SimonHubs/RoboFinch/Robofinch_assemblage_manual_dutch.pdf

Vrije Universiteit Amsterdam

# Robofinch

assembling manual

### Rogier Elsinga

6-6-2019

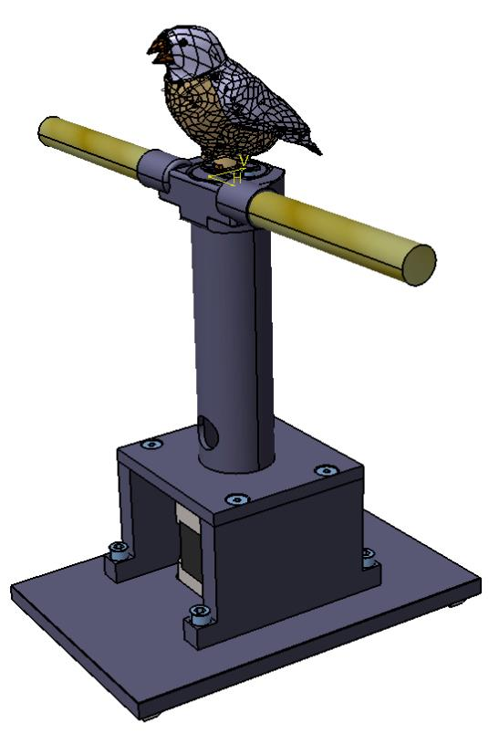
[picture p1: figure]

# Robofinch assemblage manual

## 1 Contents

Dit document beschrijft de assemblage van de robofinch zoals deze gemaakt is bij de afdeling FMIB in juni 2019. Het uitgangspunt is het afleveren van 8 robotvinken.

De hoofdfile die gebruikt is voor Catia V5R20 is:

Robofinch_assembly_w_bord_rotation17042019

In de locatie:

Z:\01-Tekeningenbestand NIEUW\2971100_dierenecologie\2971101 416101 robotvink\CAD\assembly\iteration_04172019

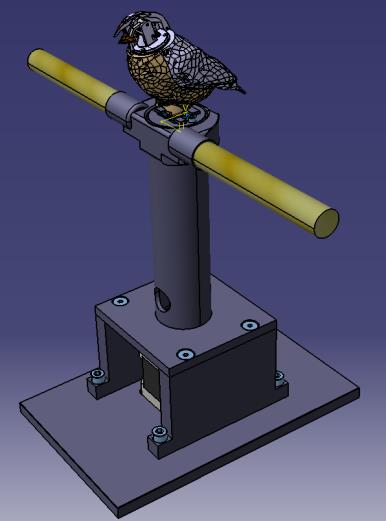
[picture p2: figure]

## 2 Het onder lichaam van de vogel

Part name: | lower_body_for_closing_chest09012019
Locatie: | Z:\01-Tekeningenbestand NIEUW\2971100_dierenecologie\2971101 416101
robotvink\CAD\assembly\iteration_12072018\lower_body_for_closing_chest_09012019.CATPart

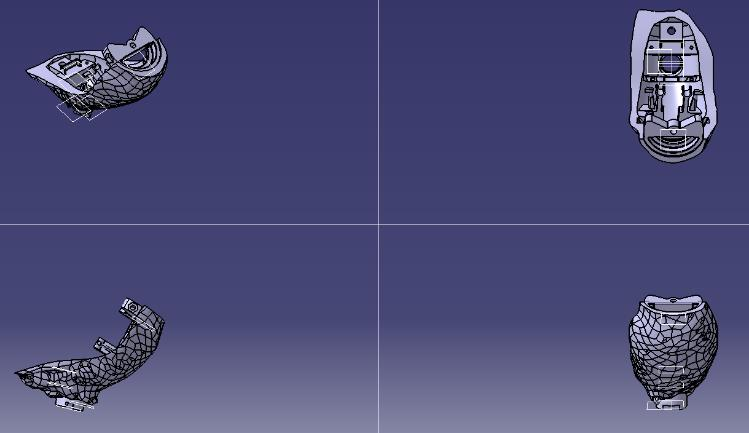
[picture p3: figure]

Printer: | Formlabs Form2
Materiaal: | Grey Pro
File naam: | batch1_lowerbody_8X
Locatie: | Z:\01-Tekeningenbestand NIEUW\2971100_dierenecologie\2971101 416101
robotvink\CAD\assembly\iteration_04172019\stl_voor_productie

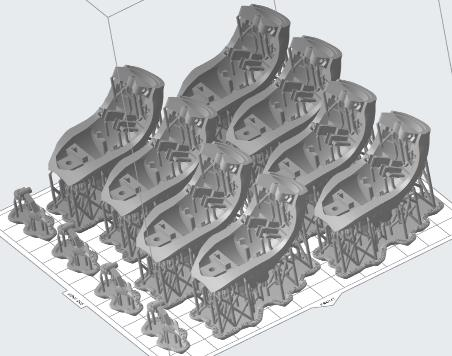
[picture p4: figure]

2.1.1 Afwerken geprint model:

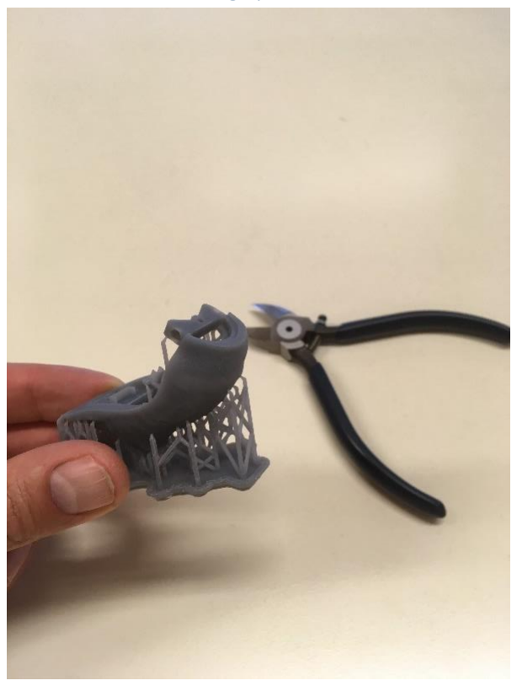
[picture p5: figure]

Na het spoelen en uiharden met de Formlabs wash en Cure alle support materiaal verwijderen en het product dusdanig netje afwerken.

2.1.2 Verlijmen van moer M1,6mm:

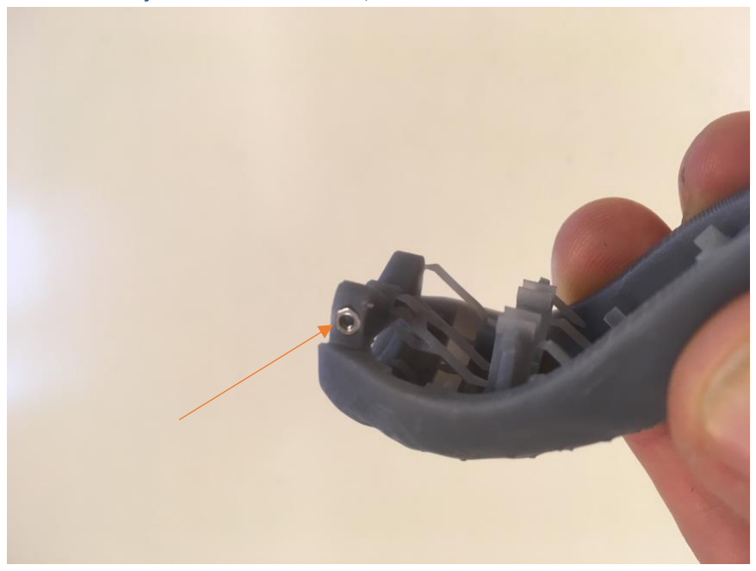
[picture p6: figure]

Moer 1,6mm verlijmen aan beide kanten met een druppel Pattex secondenlijm.

2.1.3 Afwerking draaivlak:

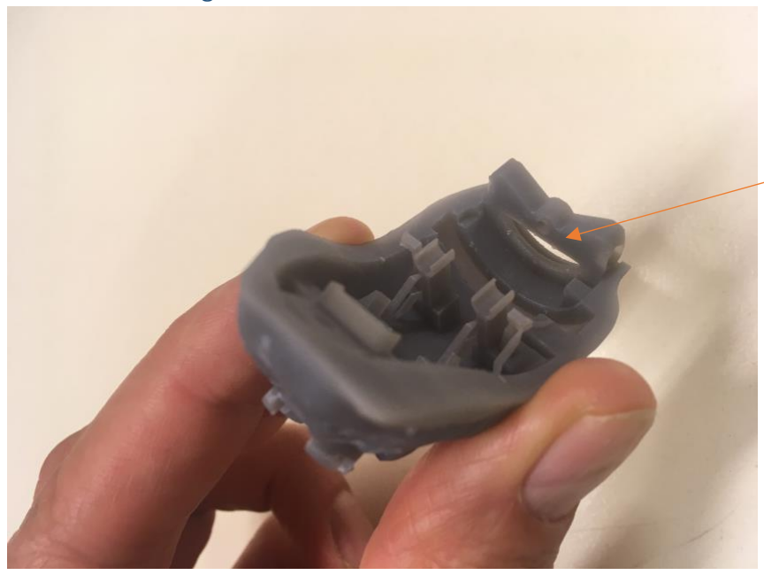
[picture p7: figure]

Zorg dat dit vlak goed vlak wordt gemaakt en vrij van oneffenheden. Dit is benodigd voor een goede werking van het hoofddraai mechanisme.

2.1.4 6 pole Din Plug demontage

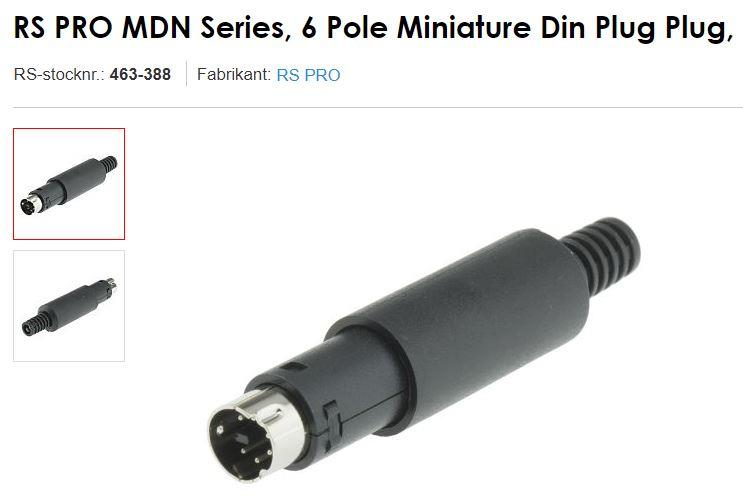
[picture p8: figure]

Deze plug wordt gedemonteerd omdat maar een deel van de plug benodigd is.

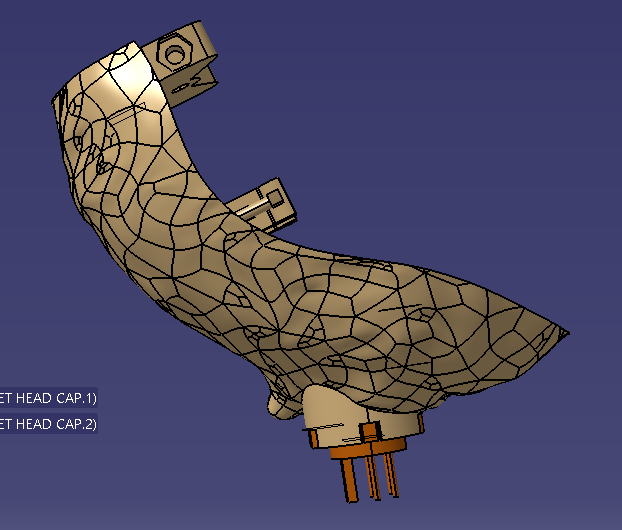
[picture p9: figure]

Volgorde van demonteren:

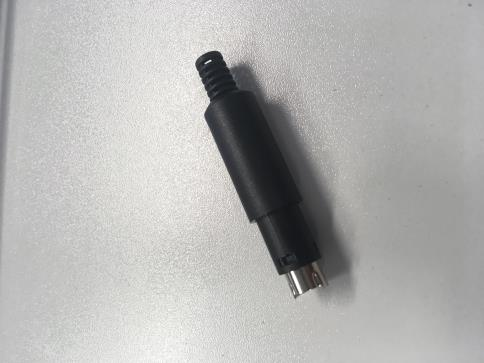
[picture p10: figure]
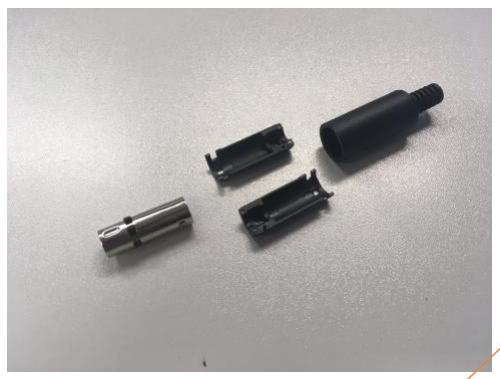
[picture p11: figure]

Benodigde onderdeel

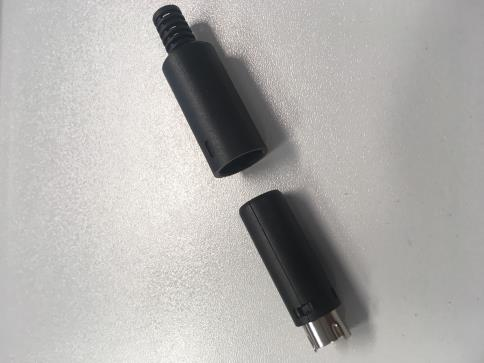
[picture p12: figure]
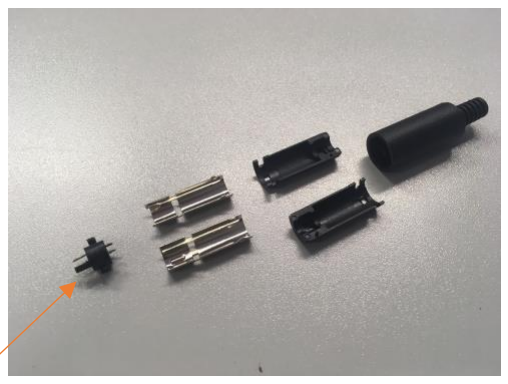
[picture p13: figure]

Let op!! Onderdelen nog niet verlijmen!

3 | Het boven lichaam van de vogel
Part name: | upper_body_solid_07122018
Locatie : | Z:\01-Tekeningenbestand NIEUW\2971100_dierenecologie\2971101 416101
robotvink\CAD\assembly\iteration_12072018\upper_body_solid_07122018.CATPart

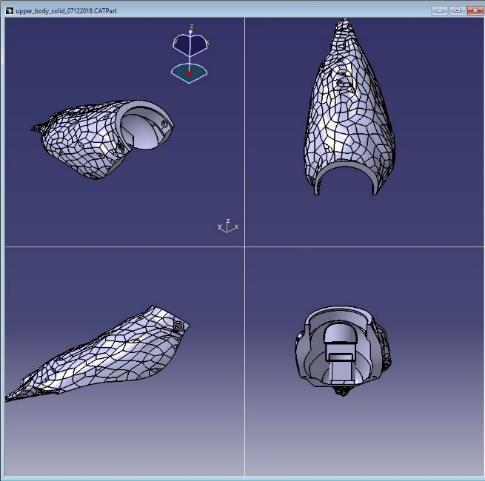
[picture p14: figure]

Printer: | Formlabs Form2
Materiaal: | Grey Pro
File naam: | batch2_upperbody4X_left_righthead4X.form
Locatie: | Z:\01-Tekeningenbestand NIEUW\2971100_dierenecologie\2971101 416101
robotvink\CAD\assembly\iteration_04172019\stl_voor_productie

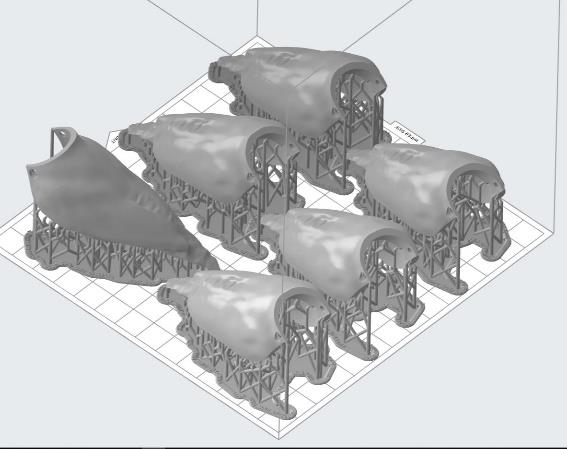
[picture p15: figure]

3.1.1 Verlijmen moer M2,5mm:

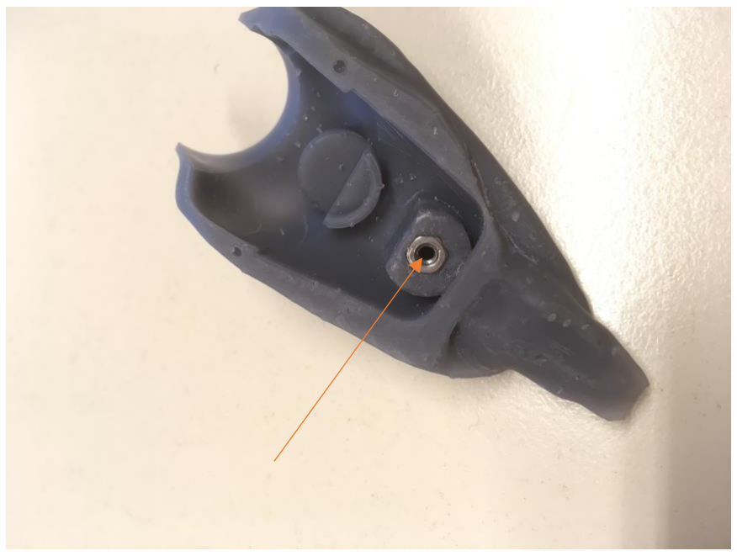
[picture p16: figure]

## 4 linker deel van de kop

Part name: | new_left_headpart_13112018
Location: | Z:\01-Tekeningenbestand NIEUW\2971100_dierenecologie\2971101 416101
robotvink\CAD\assembly\iteration_11082018\13112018\new_left_headpart_13112018.CATPart

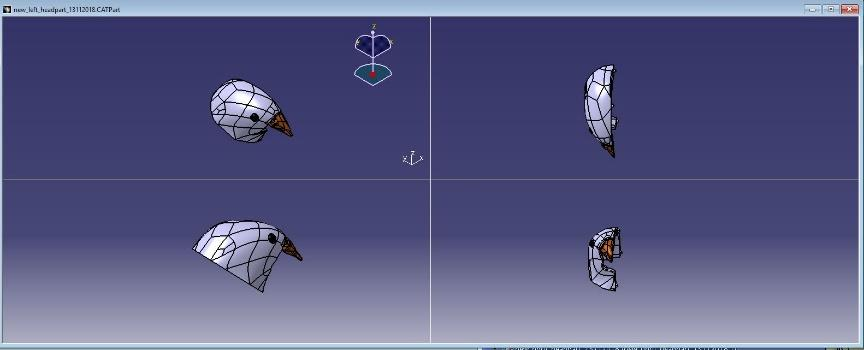
[picture p17: figure]

Printer: | Formlabs Form2
Materiaal: | Grey Pro
File naam: | batch9_leftright_head8X.form
Locatie: | Z:\01-Tekeningenbestand NIEUW\2971100_dierenecologie\2971101 416101
robotvink\CAD\assembly\iteration_04172019\stl_voor_productie

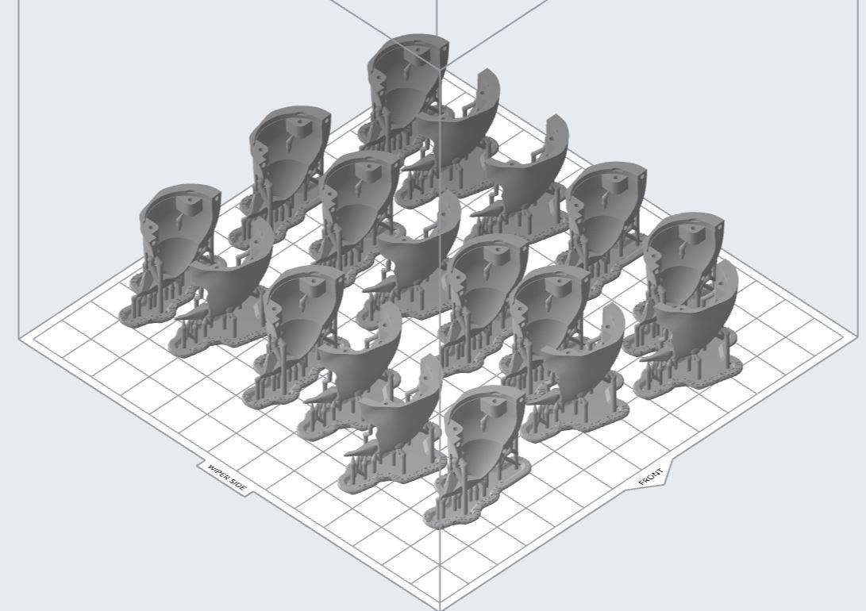
[picture p18: figure]
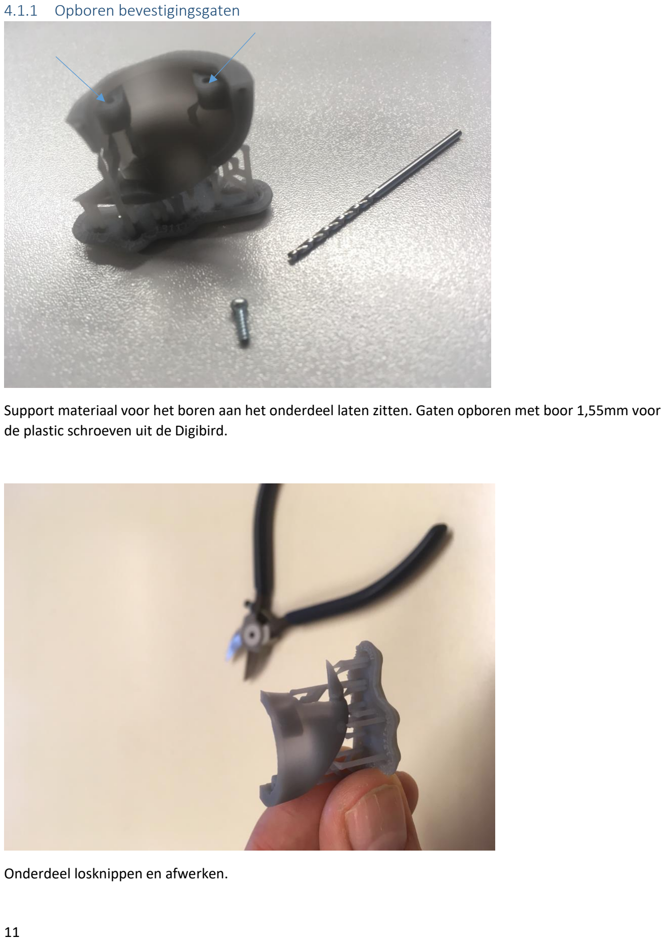
[picture p19: page 12]

4.1.1 Opboren bevestigingsgaten

Support materiaal voor het boren aan het onderdeel laten zitten. Gaten opboren met boor 1,55mm voor de plastic schroeven uit de Digibird.

Onderdeel losknippen en afwerken.

## 5 rechter deel van de kop

Part name: | new_right_headpart_13112018
Location: | Z:\01-Tekeningenbestand NIEUW\2971100_dierenecologie\2971101 416101
robotvink\CAD\assembly\iteration_11082018\13112018\new_right_headpart_13112018.CATPart

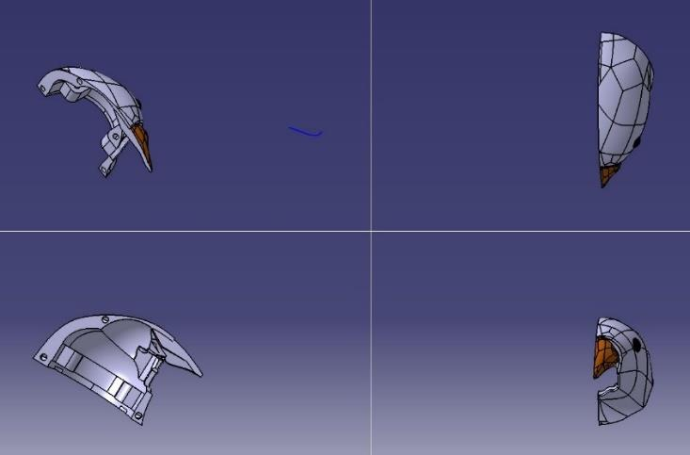
[picture p20: figure]

Printer: | Formlabs Form2
Materiaal: | Grey Pro
File naam: | batch9_leftright_head8X.form
Locatie: | Z:\01-Tekeningenbestand NIEUW\2971100_dierenecologie\2971101 416101
robotvink\CAD\assembly\iteration_04172019\stl_voor_productie

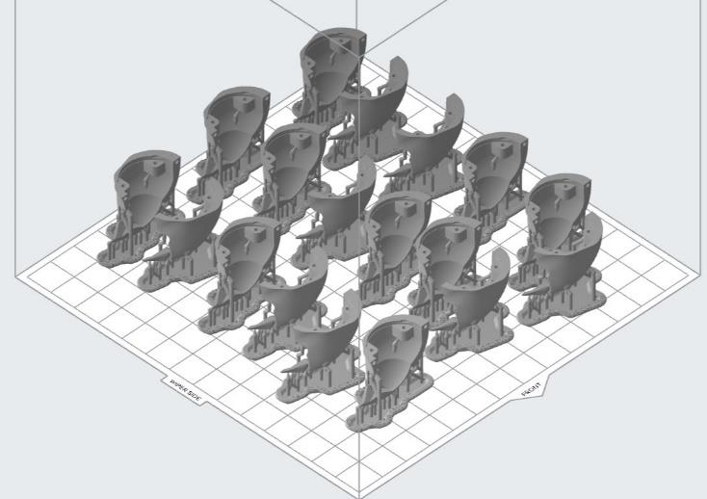
[picture p21: figure]
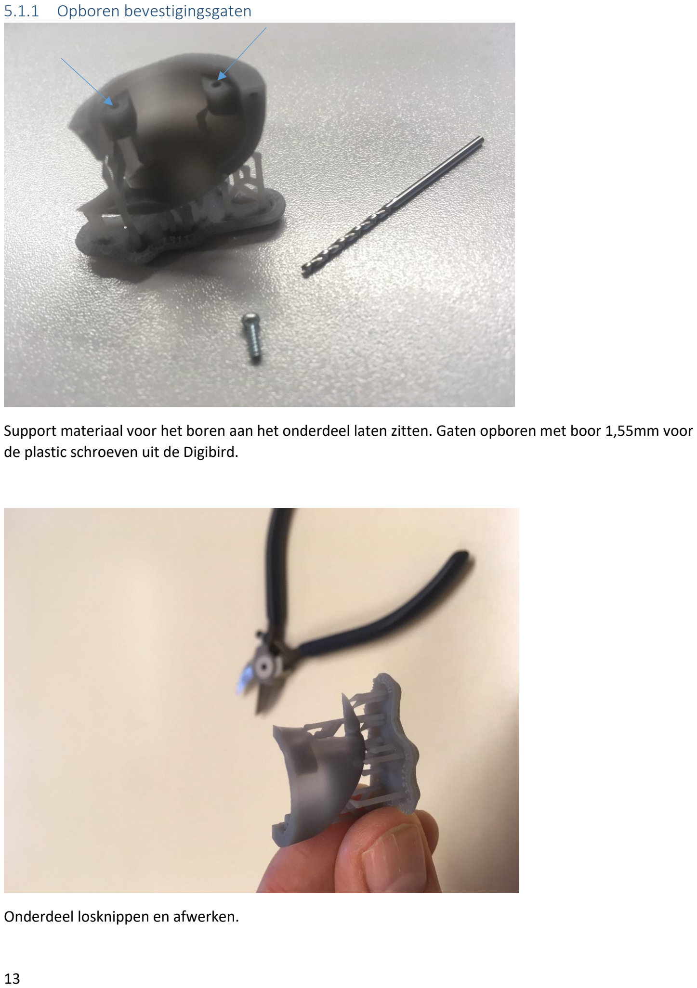
[picture p22: page 14]

5.1.1 Opboren bevestigingsgaten

Support materiaal voor het boren aan het onderdeel laten zitten. Gaten opboren met boor 1,55mm voor de plastic schroeven uit de Digibird.

Onderdeel losknippen en afwerken.

## 6 onder snavel

Part name: | lowerbale_13112018_ALLCATPart
Location: | Z:\01-Tekeningenbestand NIEUW\2971100_dierenecologie\2971101 416101
robotvink\CAD\assembly\iteration_11082018\13112018\lowebale_13112018_AllCATPart.CATPart

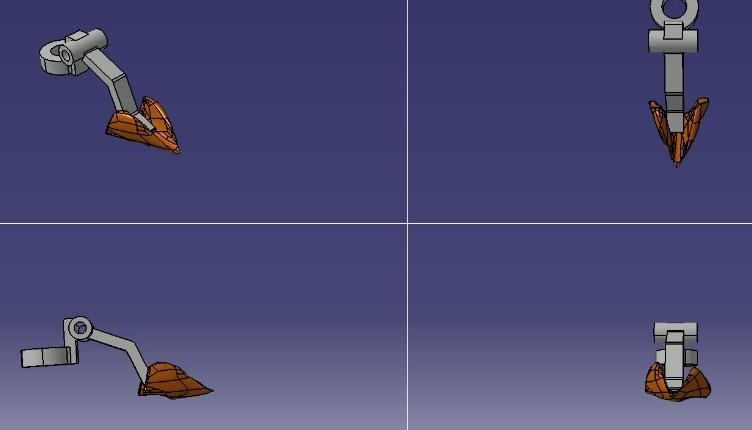
[picture p23: figure]

Printer: | Formlabs Form2
Materiaal: | Grey Pro
File naam: | batch6_left_righthead8x_bale8x.form
Locatie: | Z:\01-Tekeningenbestand NIEUW\2971100_dierenecologie\2971101 416101
robotvink\CAD\assembly\iteration_04172019\stl_voor_productie

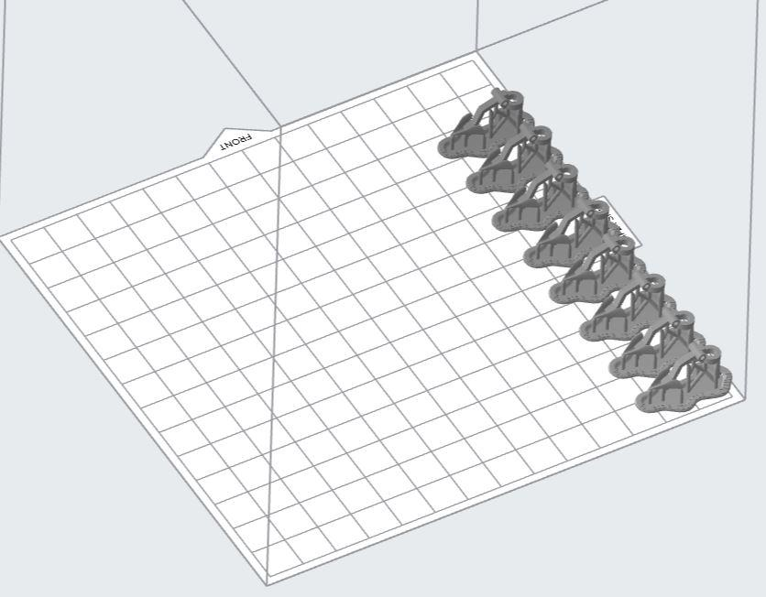
[picture p24: figure]

6.1.1 Afwerken ondersnavel

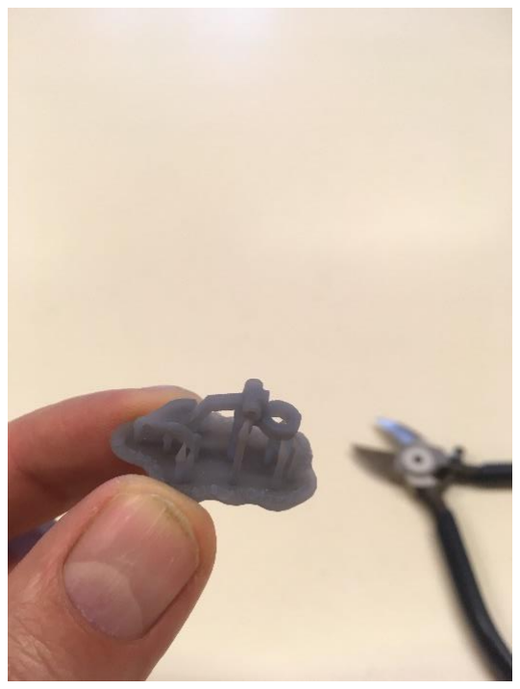
[picture p25: figure]

Onderdeel losknippen en afwerken

6.1.2 Ruimen van de ondersnavel

Voor het ruimen van de ondersnavel is een hulpstuk aanwezig

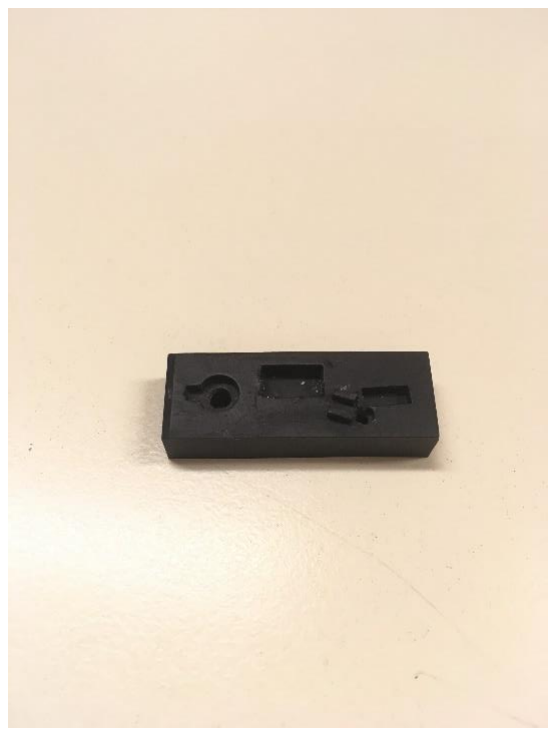
[picture p26: figure]

Het onderdeel zoals in het onderstaande afbeelding in het hulpstuk plaatsen en het gat van 1,5mm voorzichtig ruimen met ruimer 1,52H7.

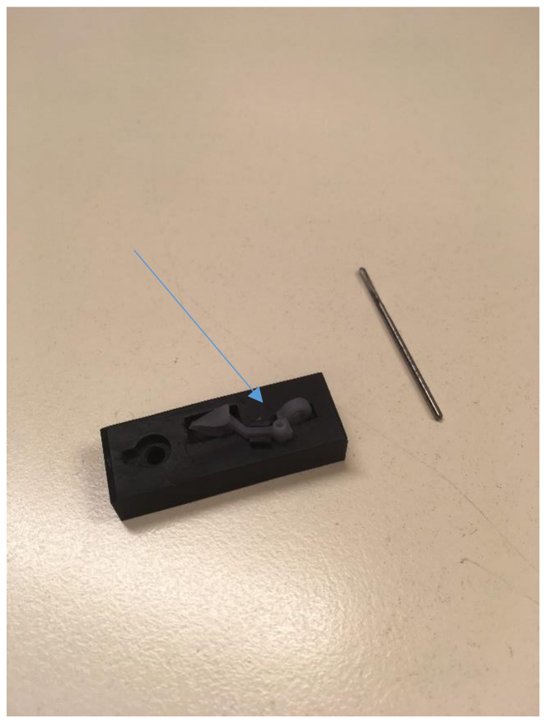
[picture p27: figure]
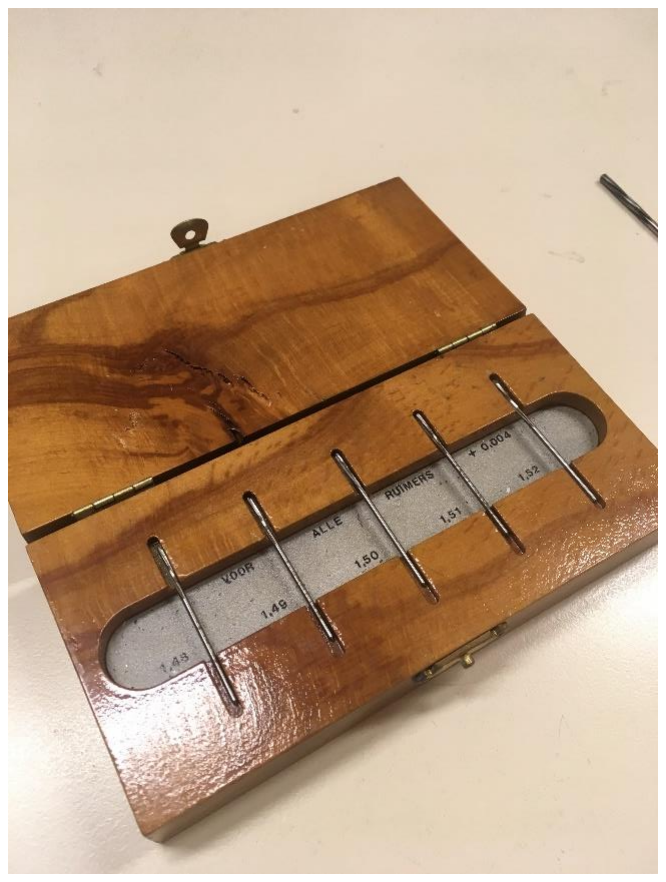
[picture p28: figure]

Het gat van rond 3mm wordt gebruikt voor het klemmen van de magneet. Onderdeel in het hulpstuk plaatsen zoals in het onderstaande figuur daarna voorzichtig ruimen met ruimer 2,99H7mm. Magneet voorzichtig met de markering naar boven in het onderdeel persen.

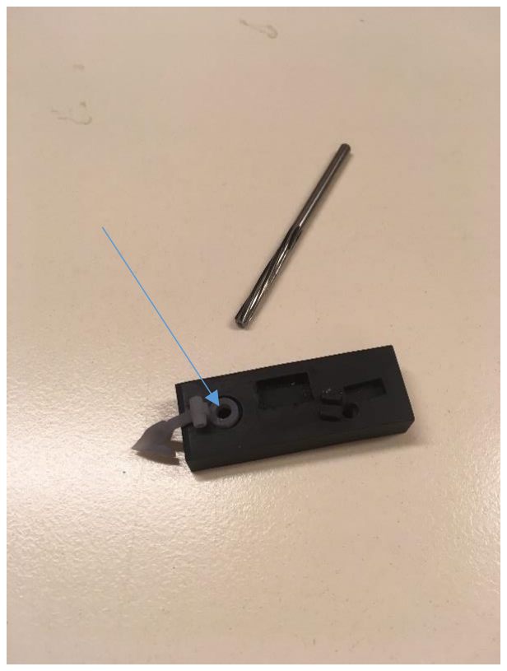
[picture p29: figure]
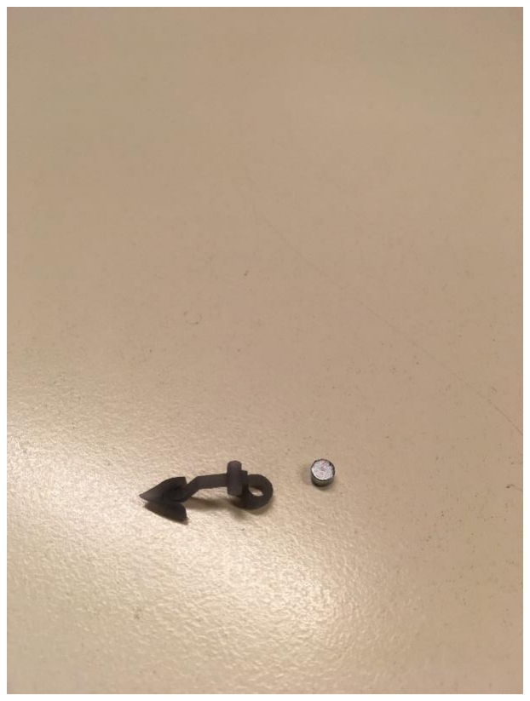
[picture p30: figure]

## 7 rotatie plaat

Part name: | rotatieplaat_21032019
Location: | Z:\01-Tekeningenbestand NIEUW\2971100_dierenecologie\2971101 416101
robotvink\CAD\assembly\iteration_03202019\rotatieplaat_21032019.CATPart

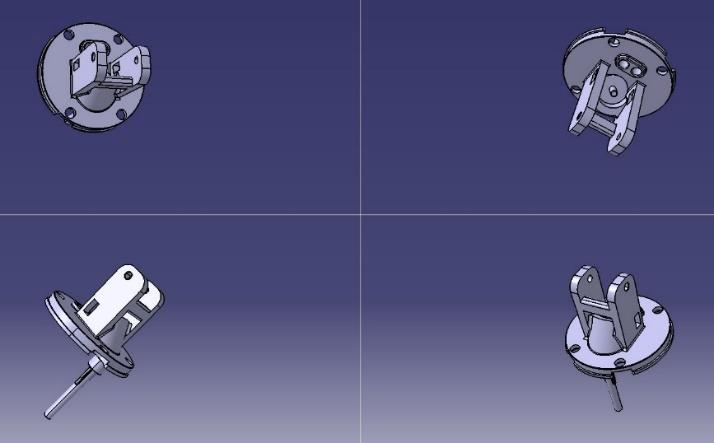
[picture p31: figure]

Printer: | Formlabs Form2
Materiaal: | Rigid
File naam: | batch8_hoofdrotatieplaat8X.form
Locatie: | Z:\01-Tekeningenbestand NIEUW\2971100_dierenecologie\2971101 416101
robotvink\CAD\assembly\iteration_04172019\stl_voor_productie

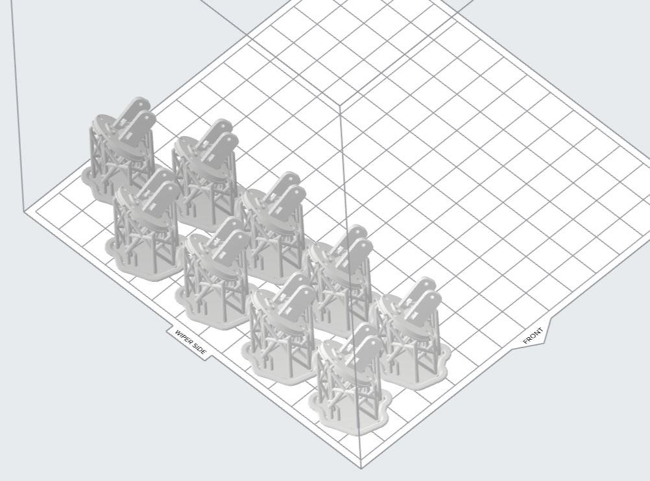
[picture p32: figure]

7.1.1 Afwerken van de rotatie plaat

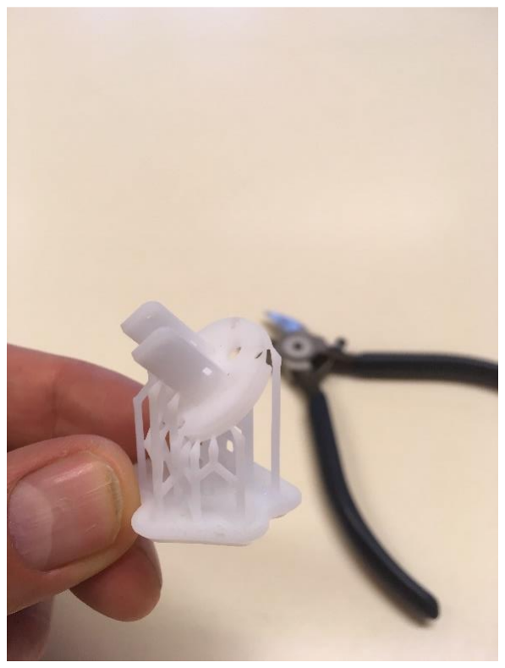
[picture p33: figure]

Losknippen van het onderdeel

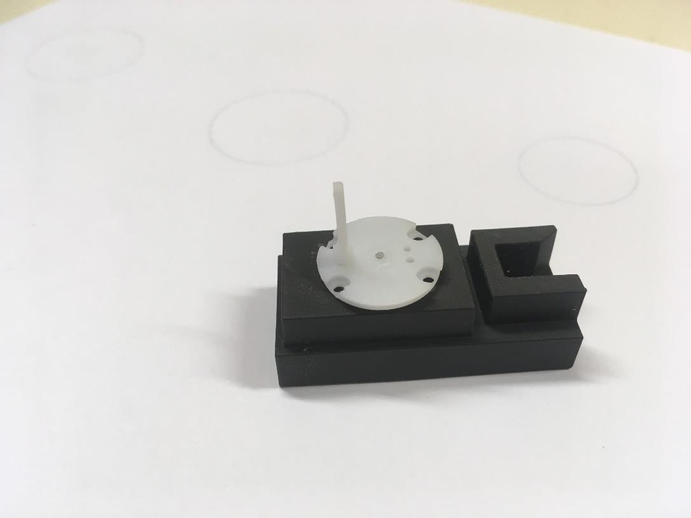
[picture p34: figure]

7.1.2 Gat M1,6mm tappen

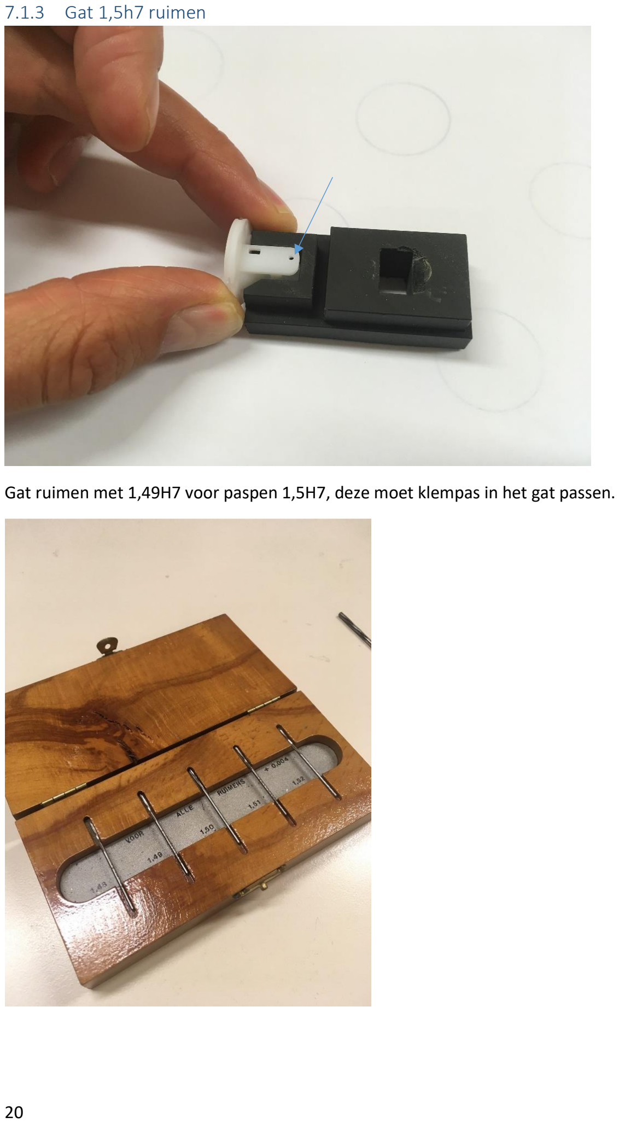
[picture p35: page 21]

7.1.3 Gat 1,5h7 ruimen

Gat ruimen met 1,49H7 voor paspen 1,5H7, deze moet klempas in het gat passen.

7.1.4 Ondervlak afwerken

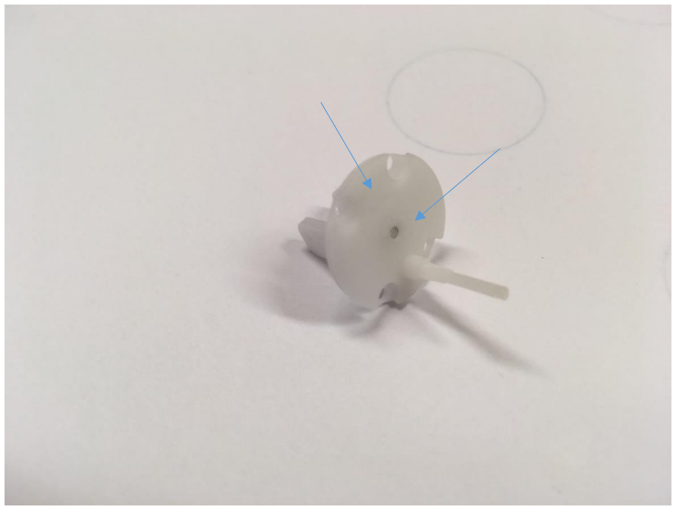
[picture p36: figure]

De ondervlakken goed afwerken op oneffenheden. Dit zijn de draaivlakken en moeten dus goed afgewerkt zijn.

7.1.5 Inkorten schroef M1,6x8mm

Tbv de connectie van de rotatieplaat met het onder lichaam van de vogel zal er een messing schroef ingekort moeten worden. Namelijk messing schroef M1,6x8mm naar 5mm.

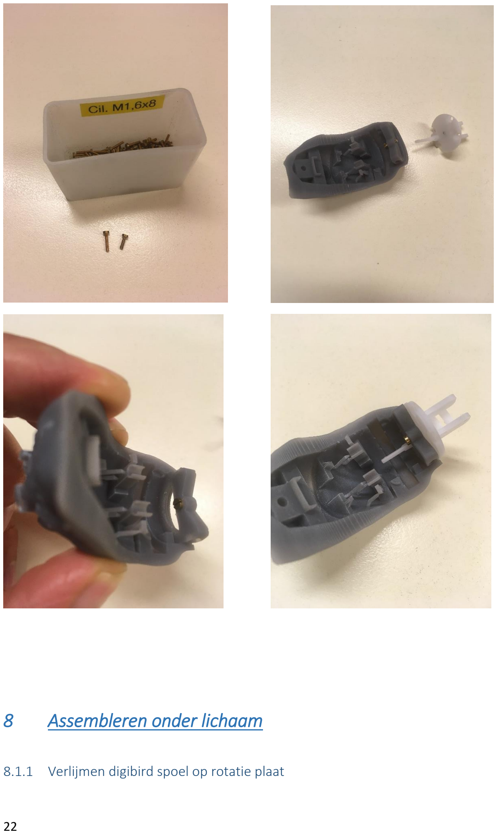
[picture p37: page 23]

## 8 Assembleren onder lichaam

8.1.1 Verlijmen digibird spoel op rotatie plaat

Lijm de spoel met een klein druppeltje Pattex secondenlijm onde onderkant vast aan de rotatieplaat.

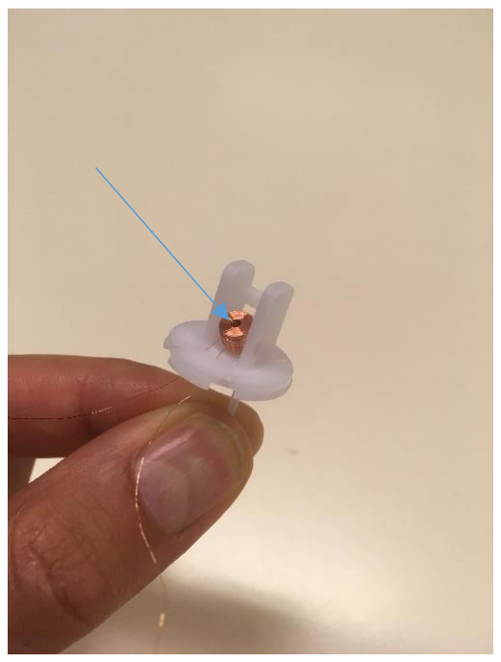
[picture p38: figure]

8.1.2 Spoeldraden vastlijmen

Geleidt de draden door de benodigde gaten lijm deze draden met een klein druppeltje secondenlijm vast in de gaten voor trekontlasting.

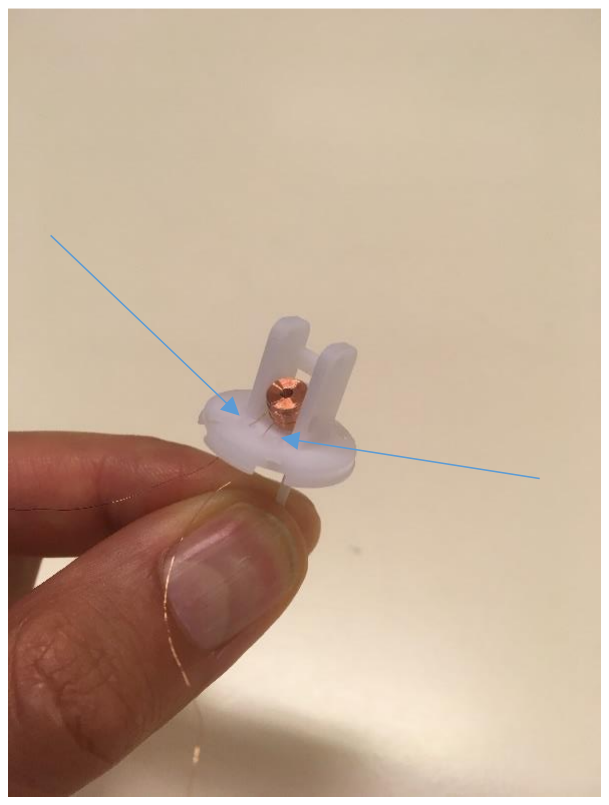
[picture p39: figure]

8.1.3 Assembleren ondersnavel met paspen

Magneet 3x2mm voorzichtig in de ondersnavel persen. Dan de ondersnavel met paspen 1,5H7 x10m met de rotatie plaat verbinden.

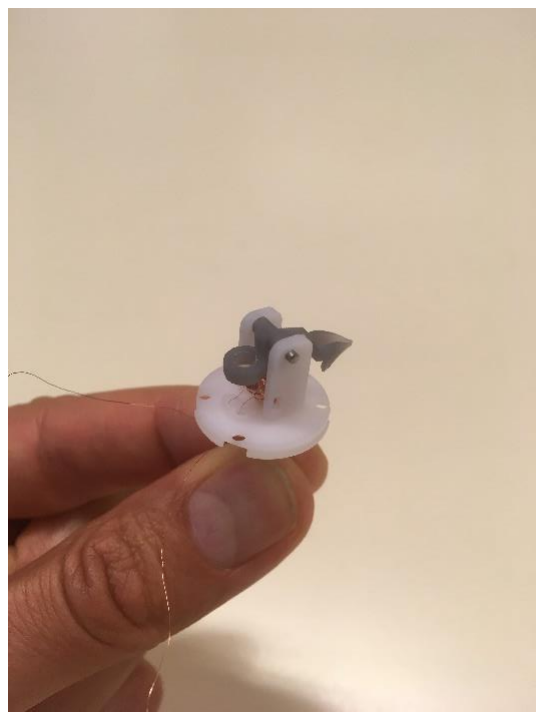
[picture p40: figure]

8.1.4 Rotatie plaat verbinden met onder lichaam

Rotatie plaat m.b.v. de schroef M1,6x5mm verbinden met het onder lichaam.

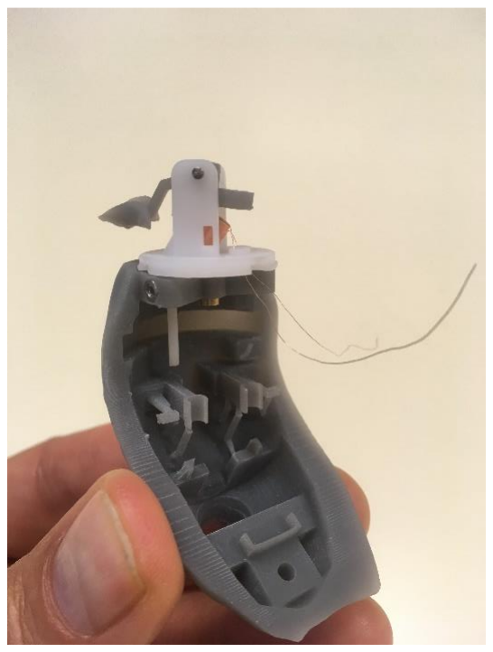
[picture p41: figure]

8.1.5 Assembleren hoofddraai mechanisme

Bevestig het hoofddraai mechanisme uit de digibird in het onder lichaam.

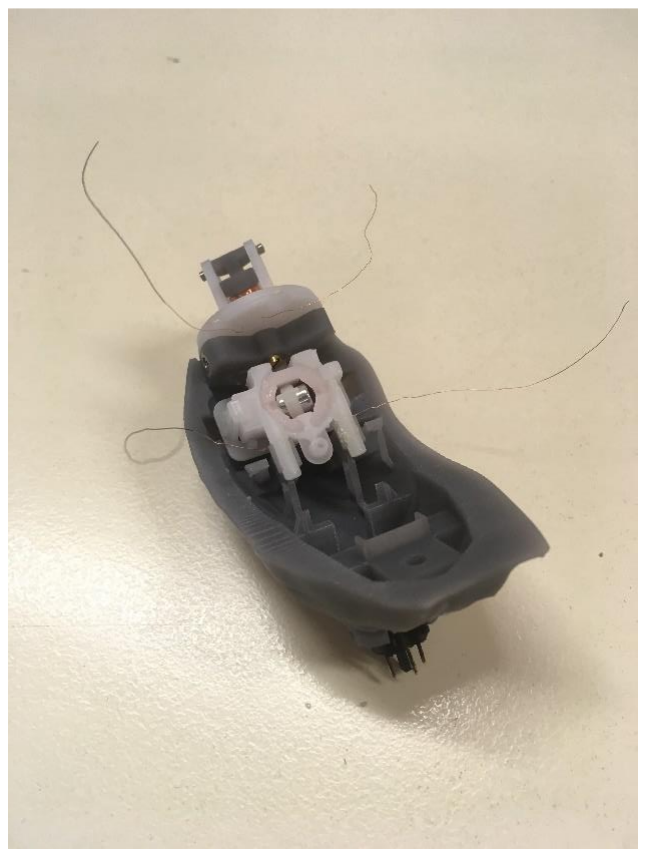
[picture p42: figure]
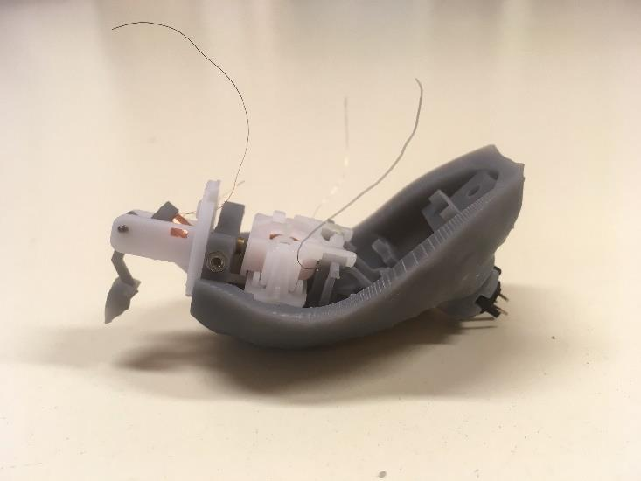
[picture p43: figure]

De DIN plug aan de onderkant van het lichaam indrukken (nog niet verlijmen!). het is nu aan de electronica afdeling de spoel draden te verbinden met de DIN plug.

## 9 Verlijmen linker en rechter kop deel

De twee kop delen aan elkaar verlijmen met een druppel Pattex secondenlijm.

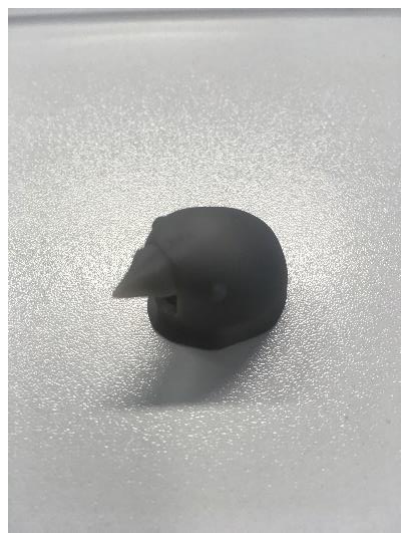
[picture p44: figure]
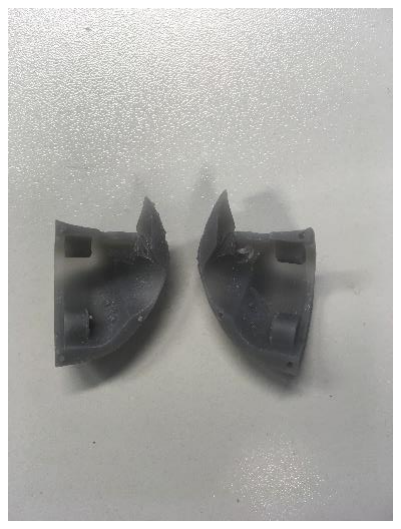
[picture p45: figure]

10 | houder
Part name: | houder
Location: | Z:\01-Tekeningenbestand NIEUW\2971100_dierenecologie\2971101 416101
robotvink\CAD\assembly\iteration_04172019\houder.CATPart

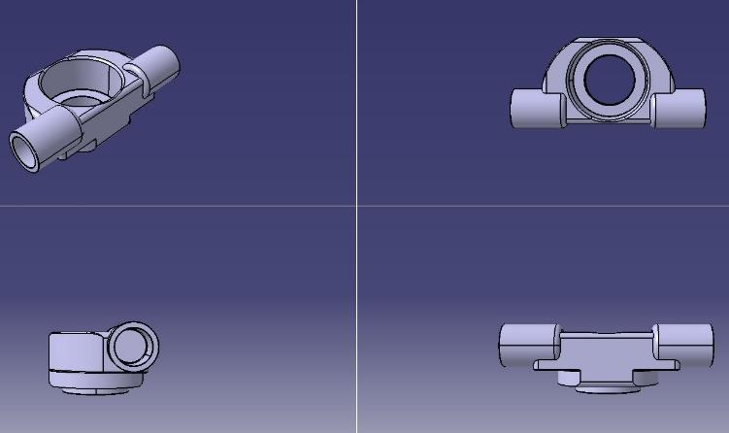
[picture p46: figure]

Printer: | Formlabs Form2
Materiaal: | Grey Pro
File naam: | batch4 en | batch444
Locatie: | Z:\01-Tekeningenbestand NIEUW\2971100_dierenecologie\2971101 416101
robotvink\CAD\assembly\iteration_04172019\stl_voor_productie

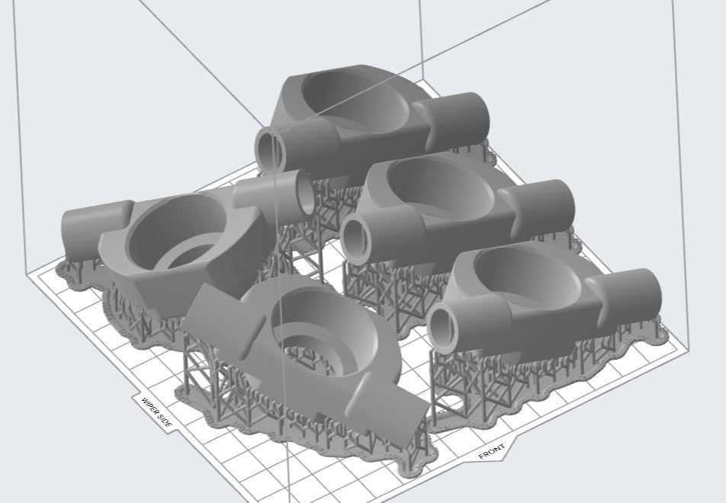
[picture p47: figure]

## 11 stappen motor rotatieplaat

Part name: | stappen_motor_rotatieplaat
Location: | Z:\01-Tekeningenbestand NIEUW\2971100_dierenecologie\2971101 416101
robotvink\CAD\assembly\iteration_04172019\stappen_motor_rotatieplaat.CATPart

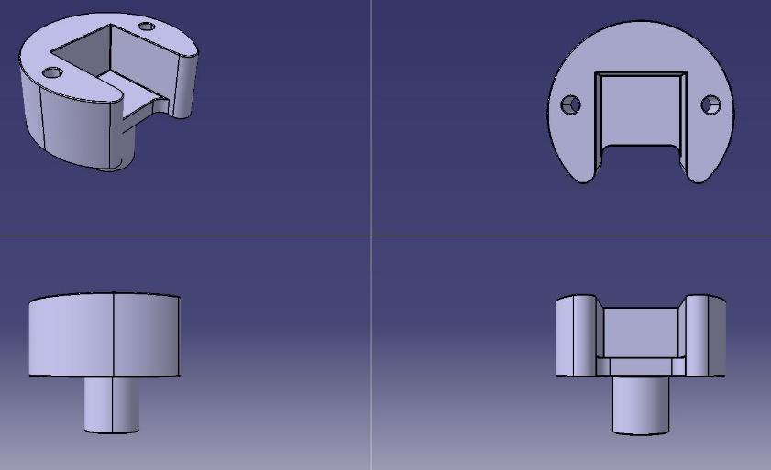
[picture p48: figure]

Printer: | Formlabs Form2
Materiaal: | Grey Pro
File naam: | batch444 | en | batch3_bale4x_motorrotatie4x_drukpl8x.form
Locatie: | Z:\01-Tekeningenbestand NIEUW\2971100_dierenecologie\2971101 416101
robotvink\CAD\assembly\iteration_04172019\stl_voor_productie

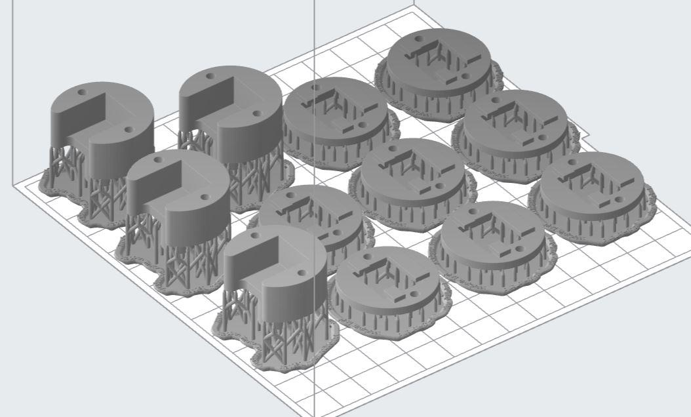
[picture p49: figure]

## 12 plug drukplaat

Part name: | plug_drukplaat
Location: | Z:\01-Tekeningenbestand NIEUW\2971100_dierenecologie\2971101 416101
robotvink\CAD\assembly\iteration_04172019\plug_drukplaat.CATPart

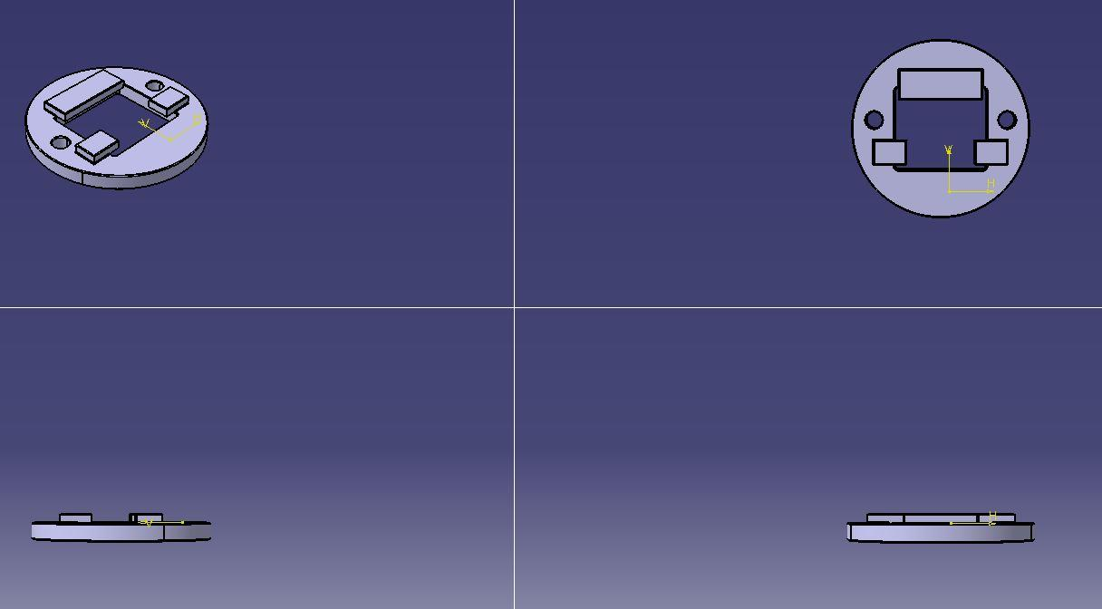
[picture p50: figure]

Printer: | Formlabs Form2
Materiaal: | Grey Pro
File naam: | batch3_bale4x_motorrotatie4x_drukpl8x.form
Locatie: | Z:\01-Tekeningenbestand NIEUW\2971100_dierenecologie\2971101 416101
robotvink\CAD\assembly\iteration_04172019\stl_voor_productie

## 13 demontage Digibird voor onderdelen

13.1.1 demonteren batterij kap

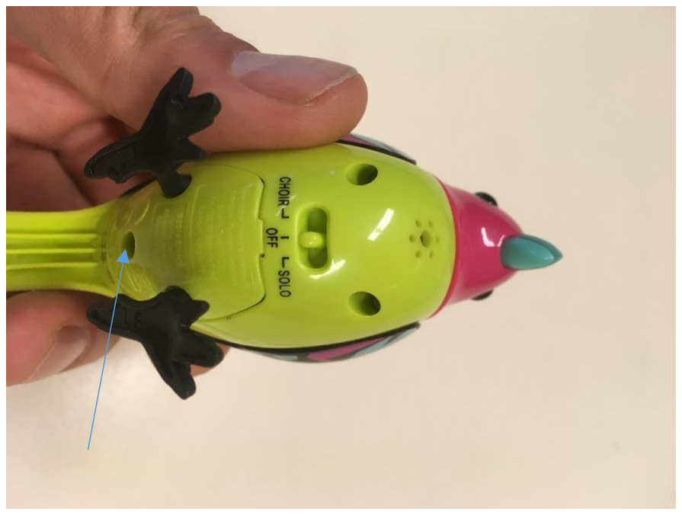
[picture p51: figure]

Batterij kap losschroeven met kleine kruiskop schroevendraaier.

13.1.2 Batterijen verwijderen

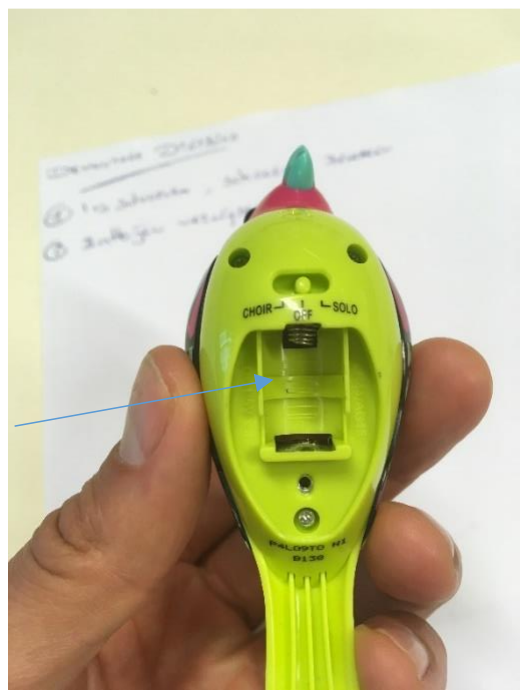
[picture p52: figure]

Verwijder de batterijen uit de body.

13.1.3 Verwijderen onderkap

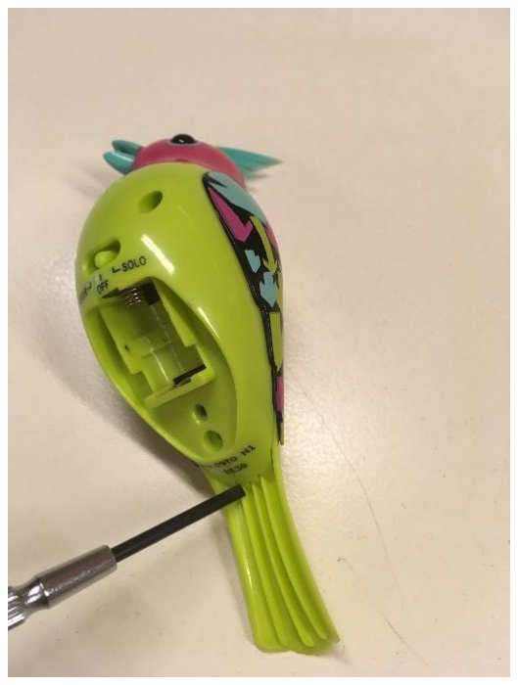
[picture p53: figure]

Wip de kap aan de onderkant los.

13.1.4 Pcb board losschroeven

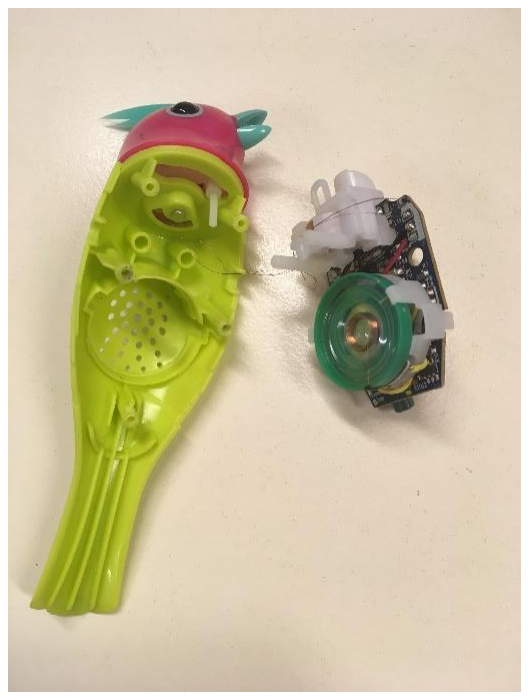
[picture p54: figure]
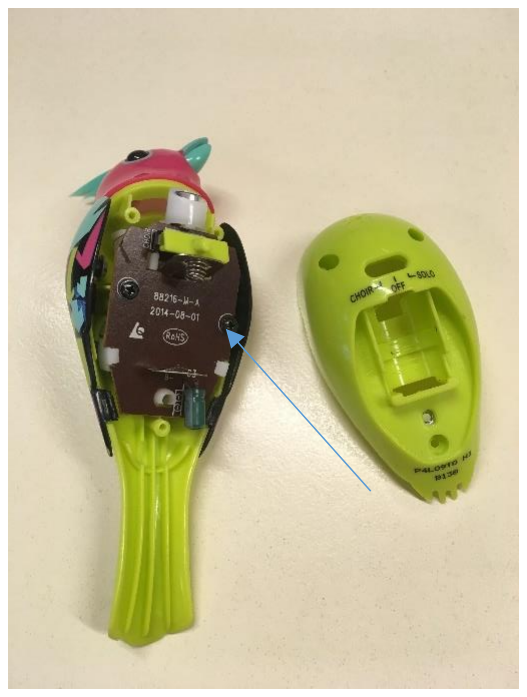
[picture p55: figure]

Schroef het pcb board los van het bovenlichaam.

13.1.5 Spoeldraden losknippen

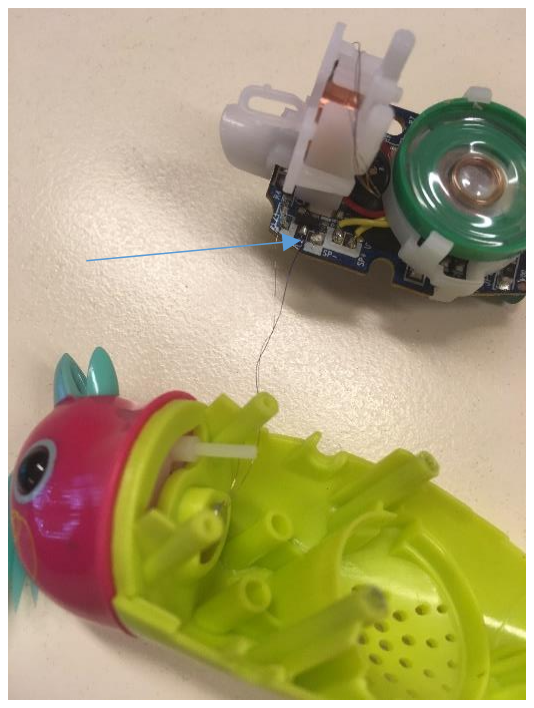
[picture p56: figure]

spoeldraden aan het pcb board kant losknippen.

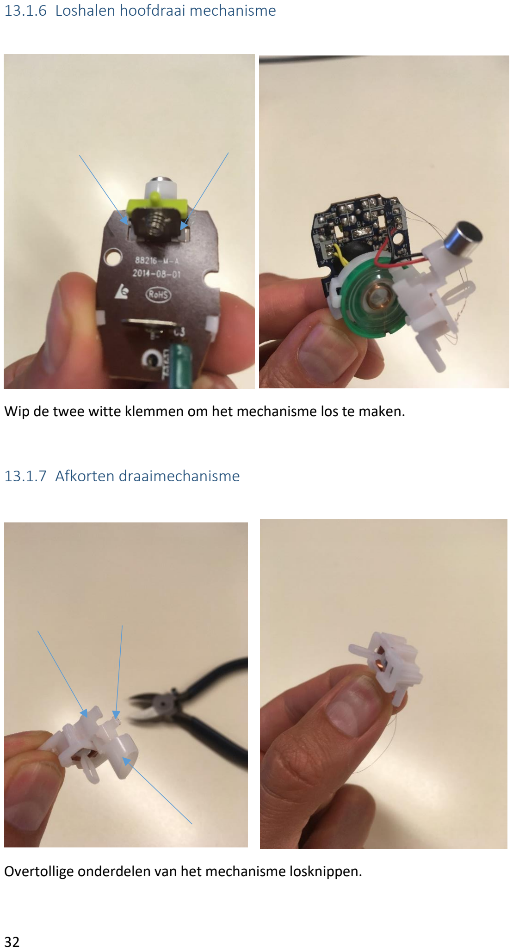
[picture p57: page 33]

13.1.6 Loshalen hoofdraai mechanisme

Wip de twee witte klemmen om het mechanisme los te maken.

13.1.7 Afkorten draaimechanisme

Overtollige onderdelen van het mechanisme losknippen.

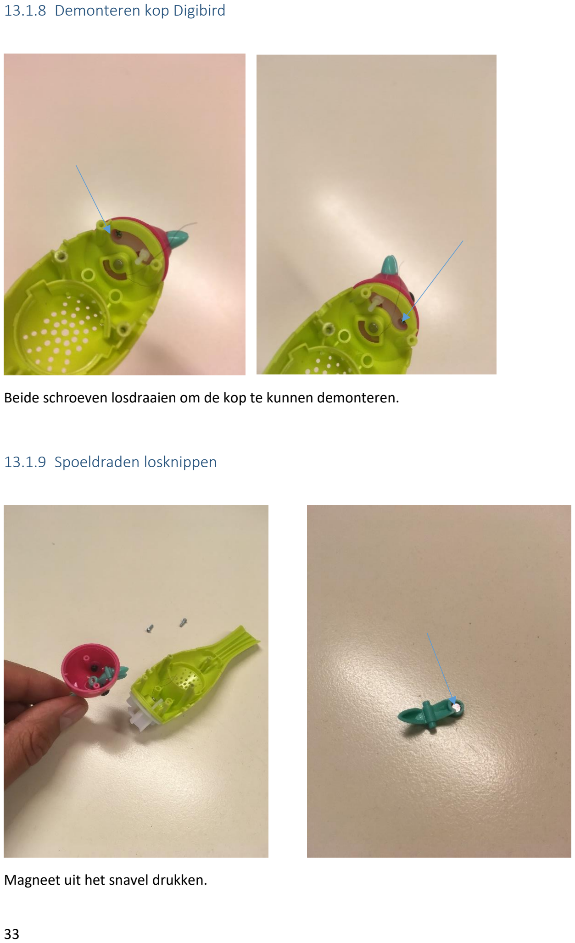
[picture p58: page 34]

13.1.8 Demonteren kop Digibird

Beide schroeven losdraaien om de kop te kunnen demonteren.

13.1.9 Spoeldraden losknippen

Magneet uit het snavel drukken.

## 14 Assembleren stand

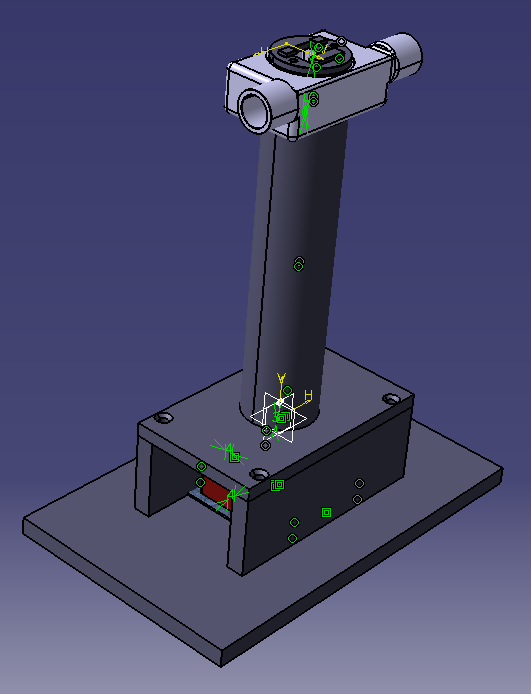
[picture p59: figure]

Bestaande uit

1 | onderplaat
2 | bovenplaat
3 | zijwand
4 | rubberen onderplaat
5 | rubberen bovenplaat
6 | as
7 | rotatie plaat
8 | plug druk plaat
9 | houder finch
10 | stepper motor NEMA 17
11 | nop

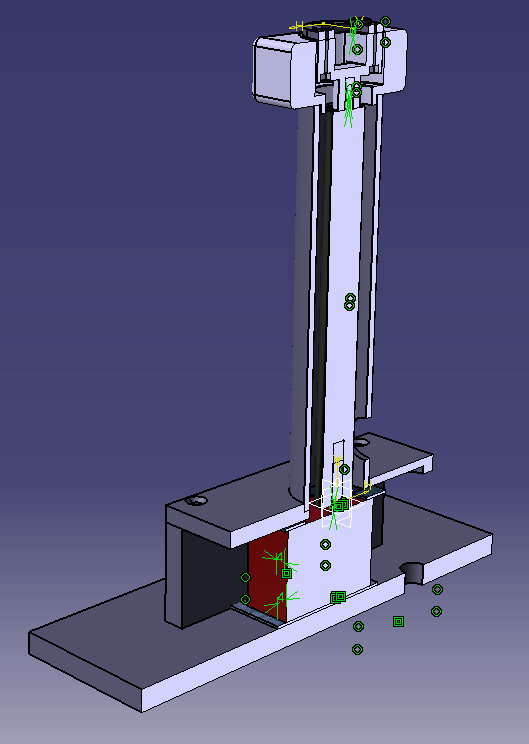
[picture p60: figure]
