SimonHubs/RoboFinch/ZebraFinchArduino.pdf

## DCBA

## BCDA

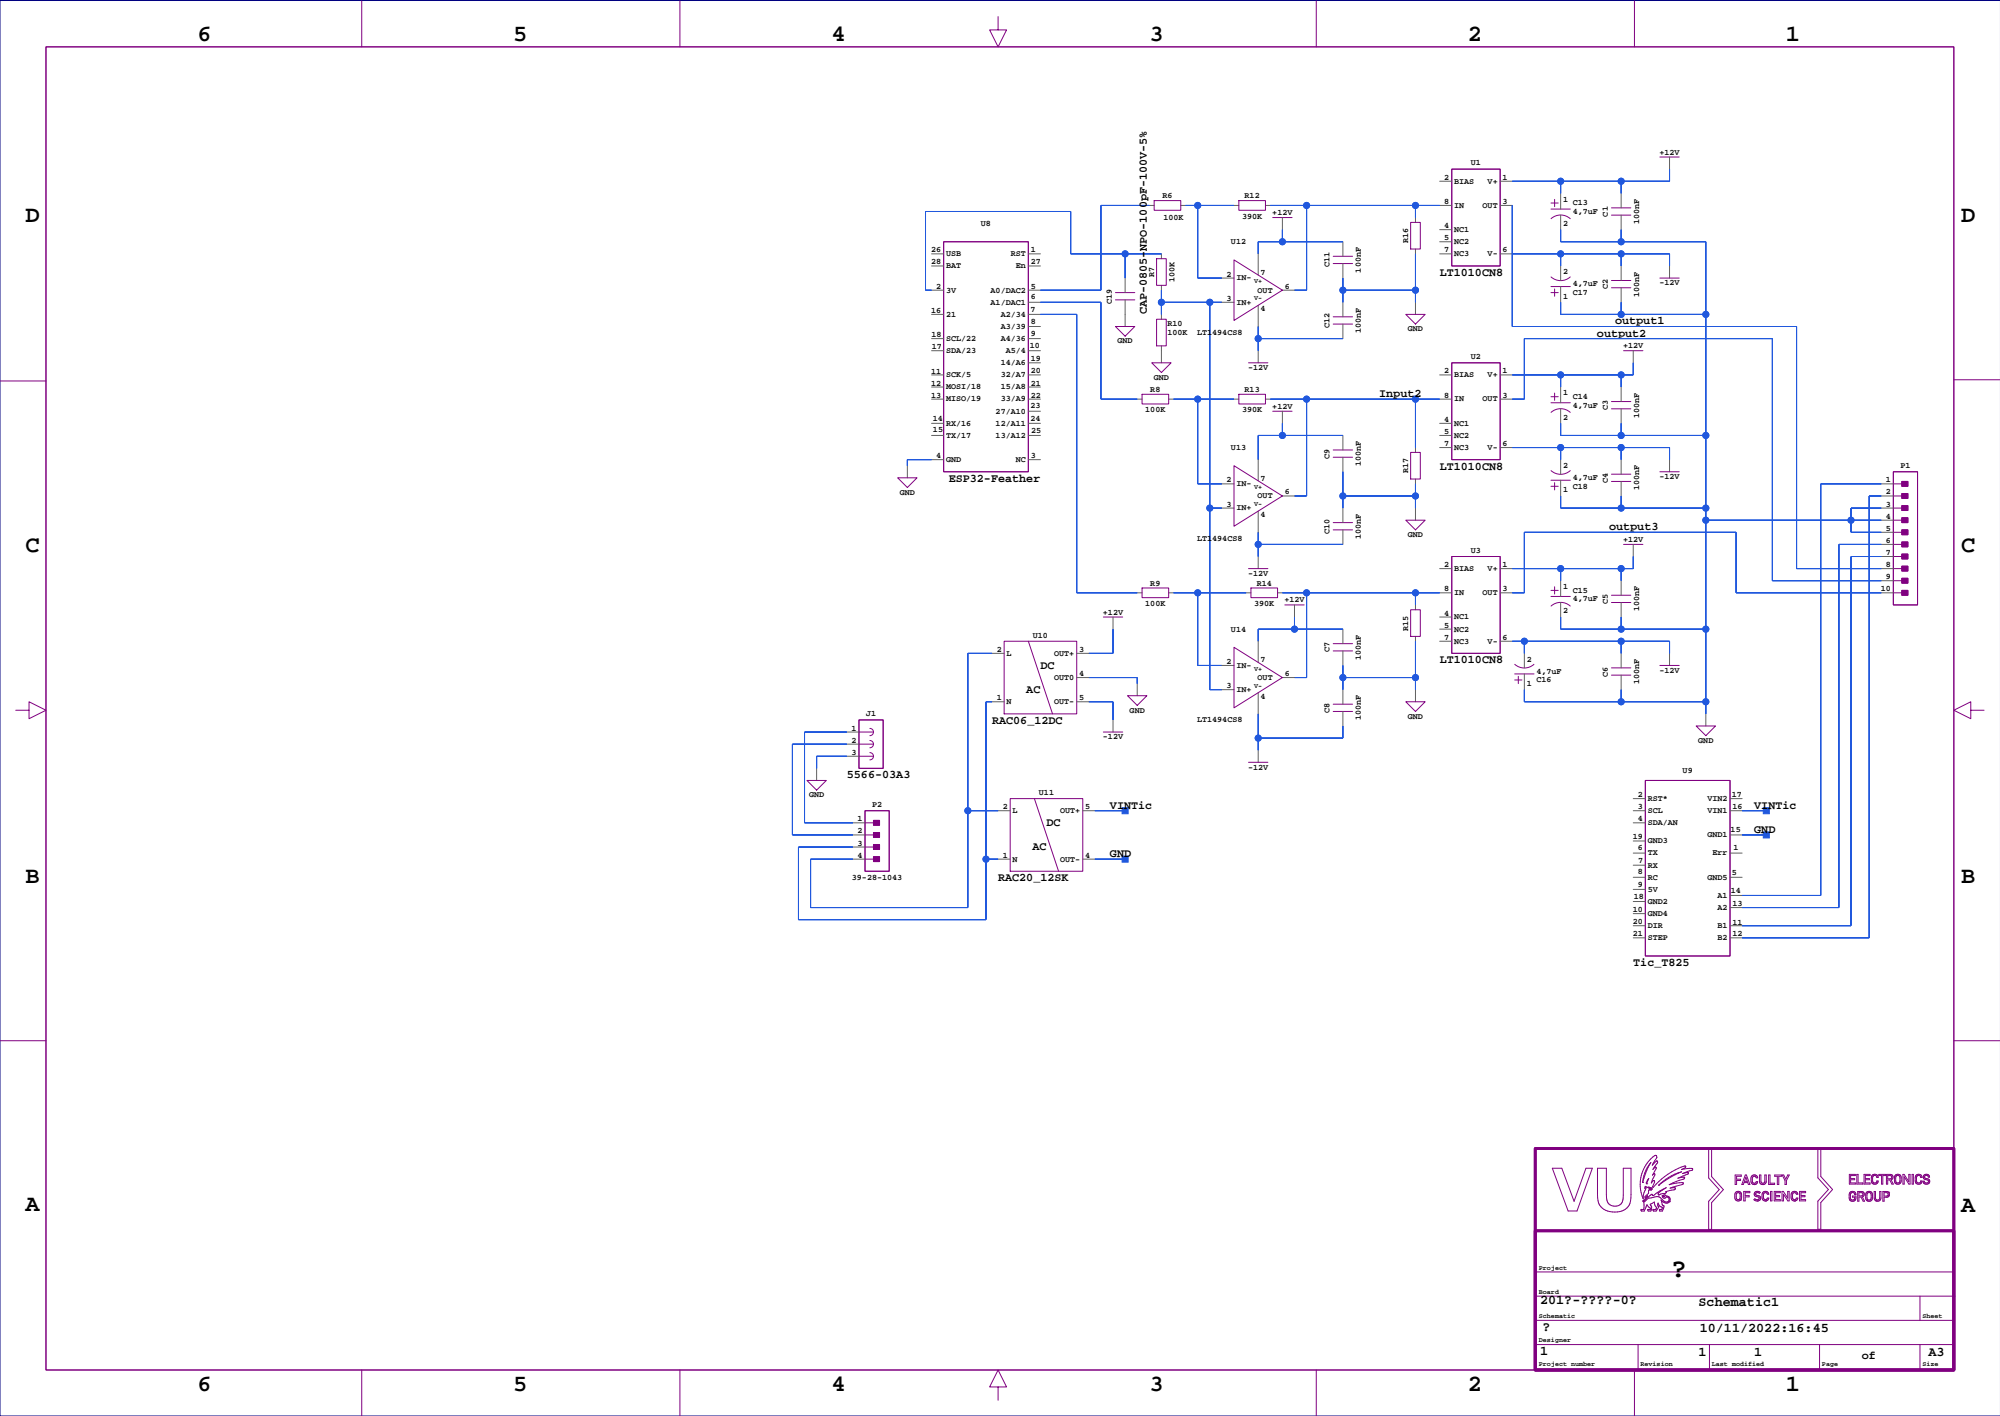
[picture p61: page 1]
